arraym/ESP8266Tetris/ESP8266Tetris_Top.png

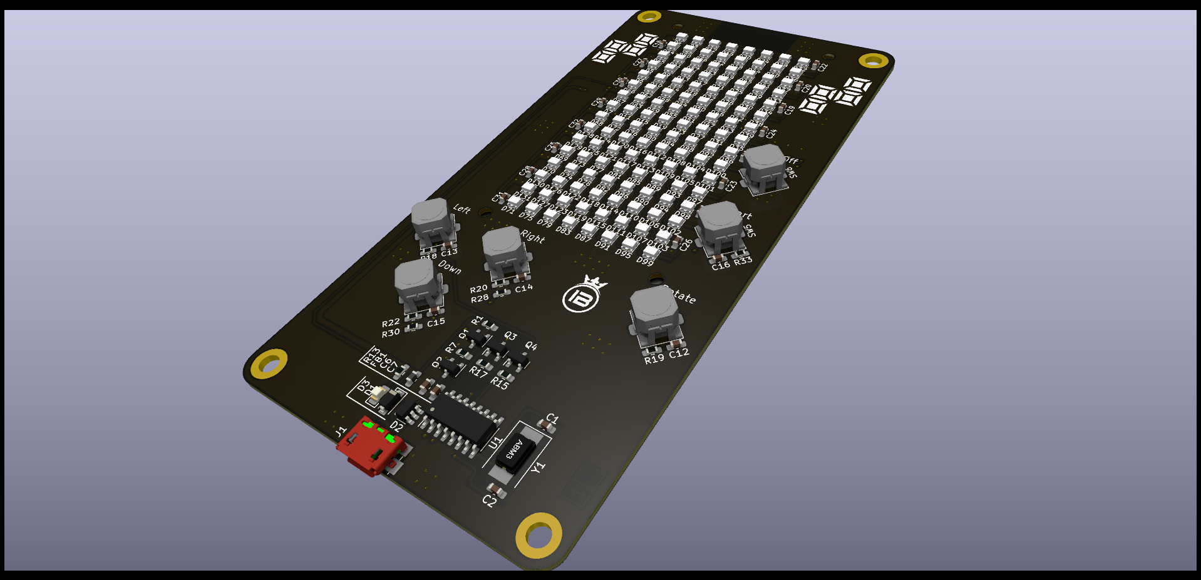
ESP8266Tetris_Top.png
