arraym/ESP8266Tetris/ESP8266Tetris_Bot.png

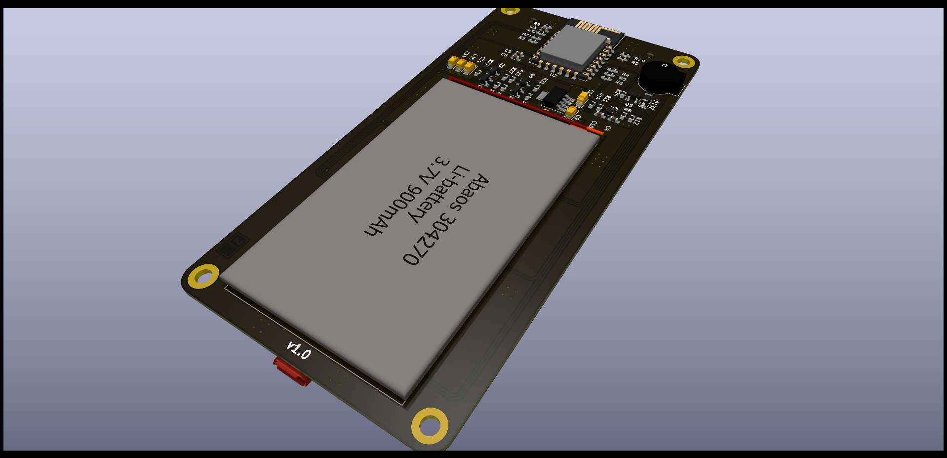
ESP8266Tetris_Bot.png
