arraym/ESP8266Tetris/Datasheets/ESP8266_PinDescription.png

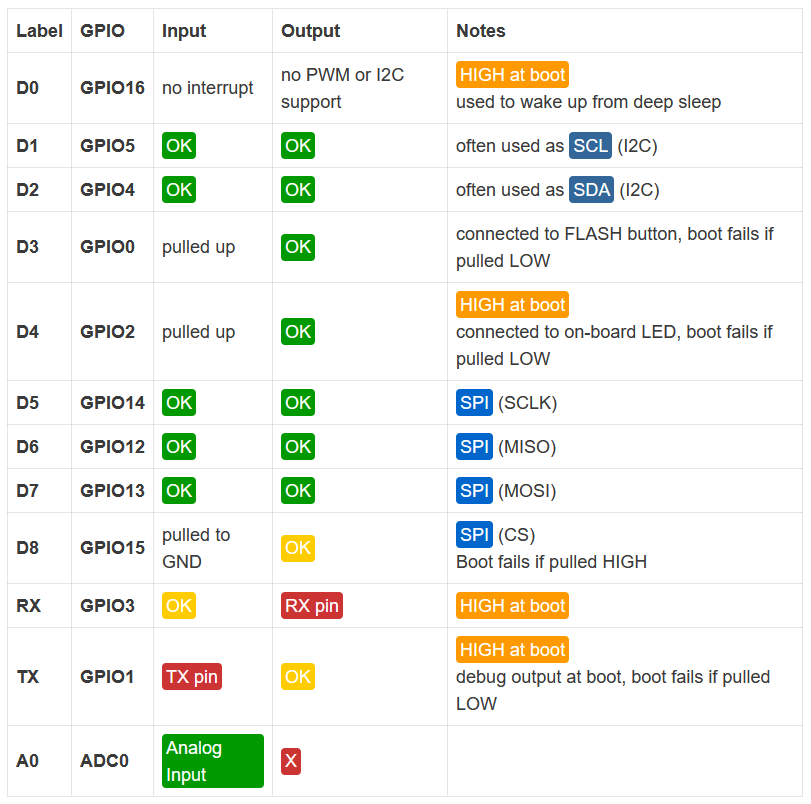
Datasheets/ESP8266_PinDescription.png
