arraym/ESP8266Tetris/Datasheets/tetris1.jpg

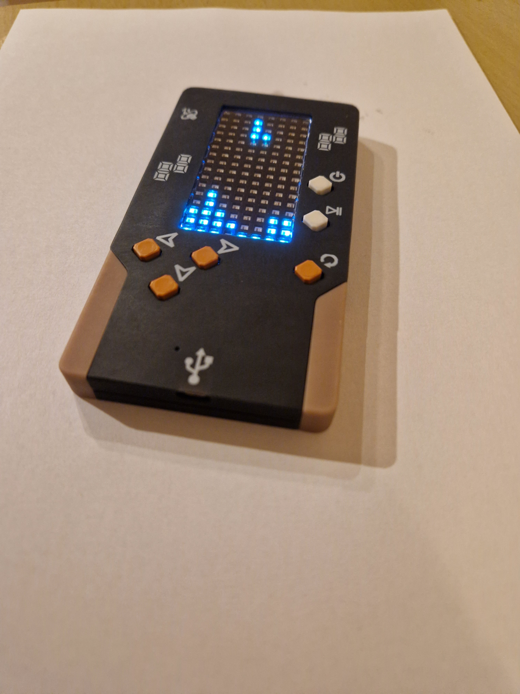
Datasheets/tetris1.jpg
