arraym/ESP8266Tetris/Datasheets/tetris2.jpg

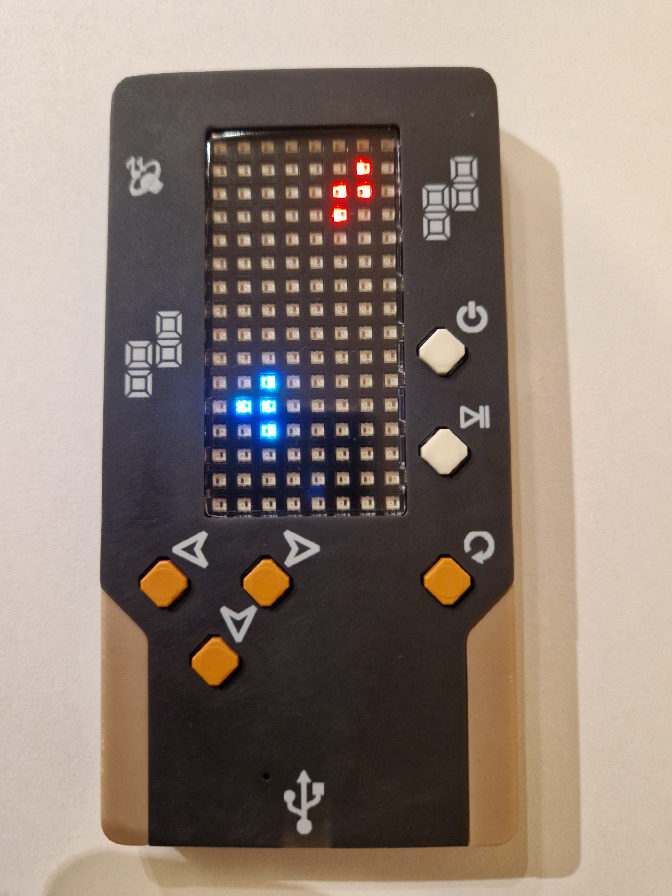
Datasheets/tetris2.jpg
