arraym/ESP8266Tetris/Datasheets/tetris3.jpg

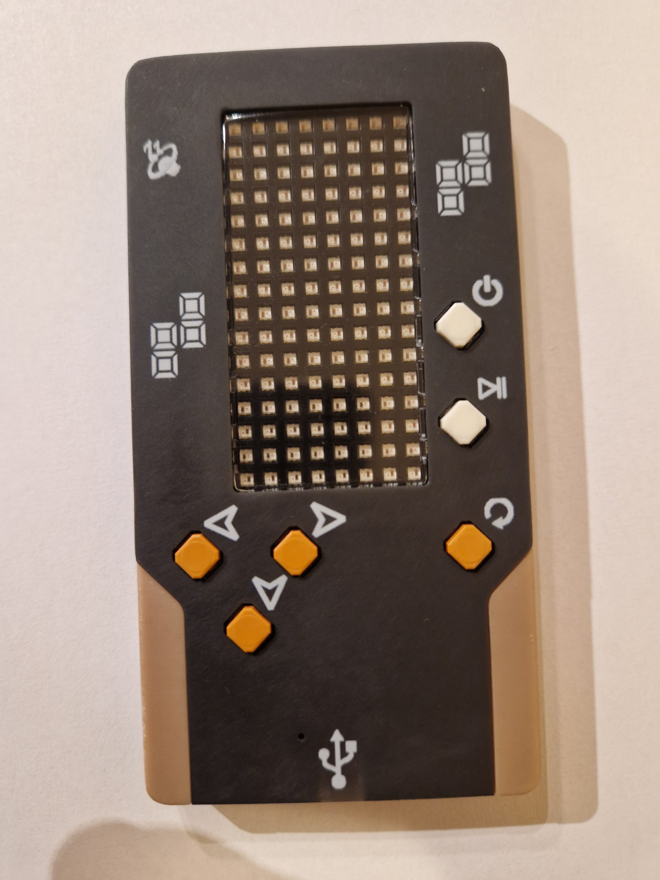
Datasheets/tetris3.jpg
