arraym/ESP8266Tetris/Datasheets/tetris4.jpg

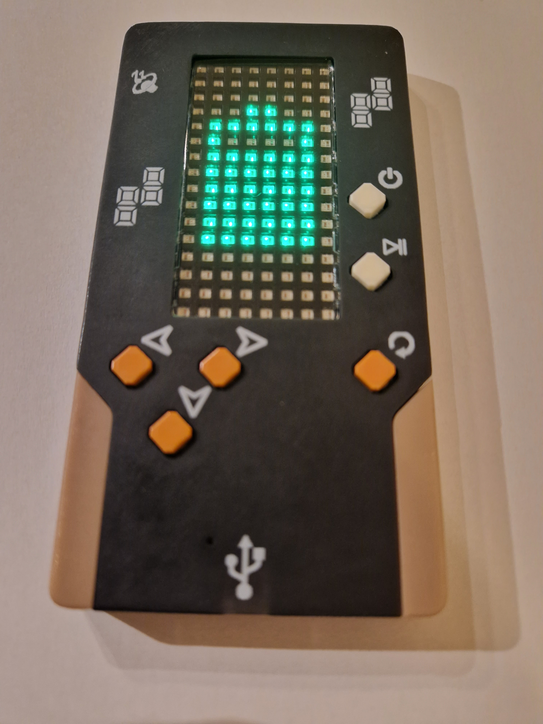
Datasheets/tetris4.jpg
