arraym/ESP8266Tetris/Datasheets/tetris5.jpg

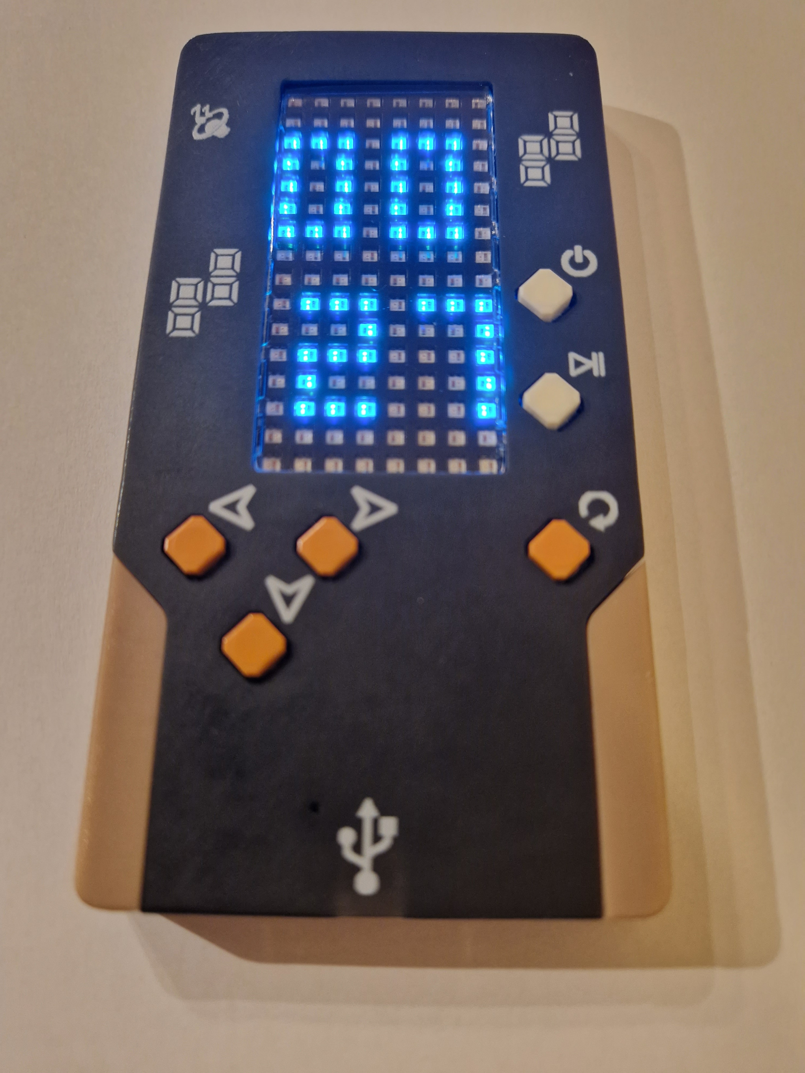
Datasheets/tetris5.jpg
