arraym/ESP8266Tetris/Datasheets/tetris6.jpg

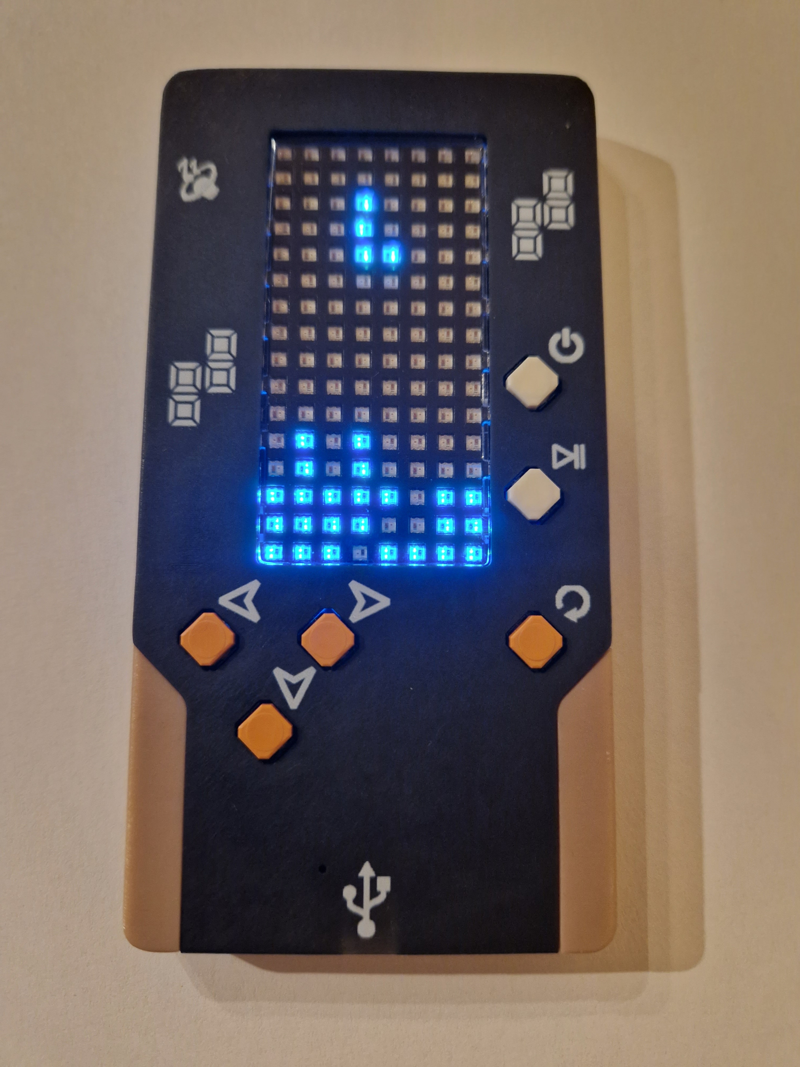
Datasheets/tetris6.jpg
