arraym/ESP8266Tetris/Datasheets/tetris7.jpg

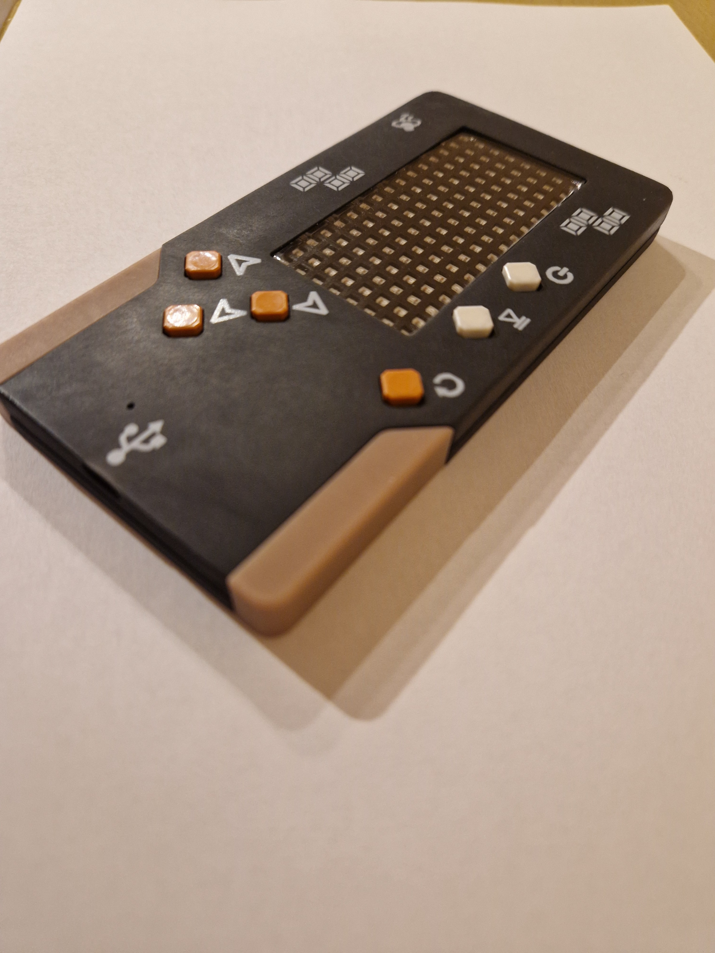
Datasheets/tetris7.jpg
