arraym/ESP8266Tetris/DocAsse/ESP8266Tetris.pdf

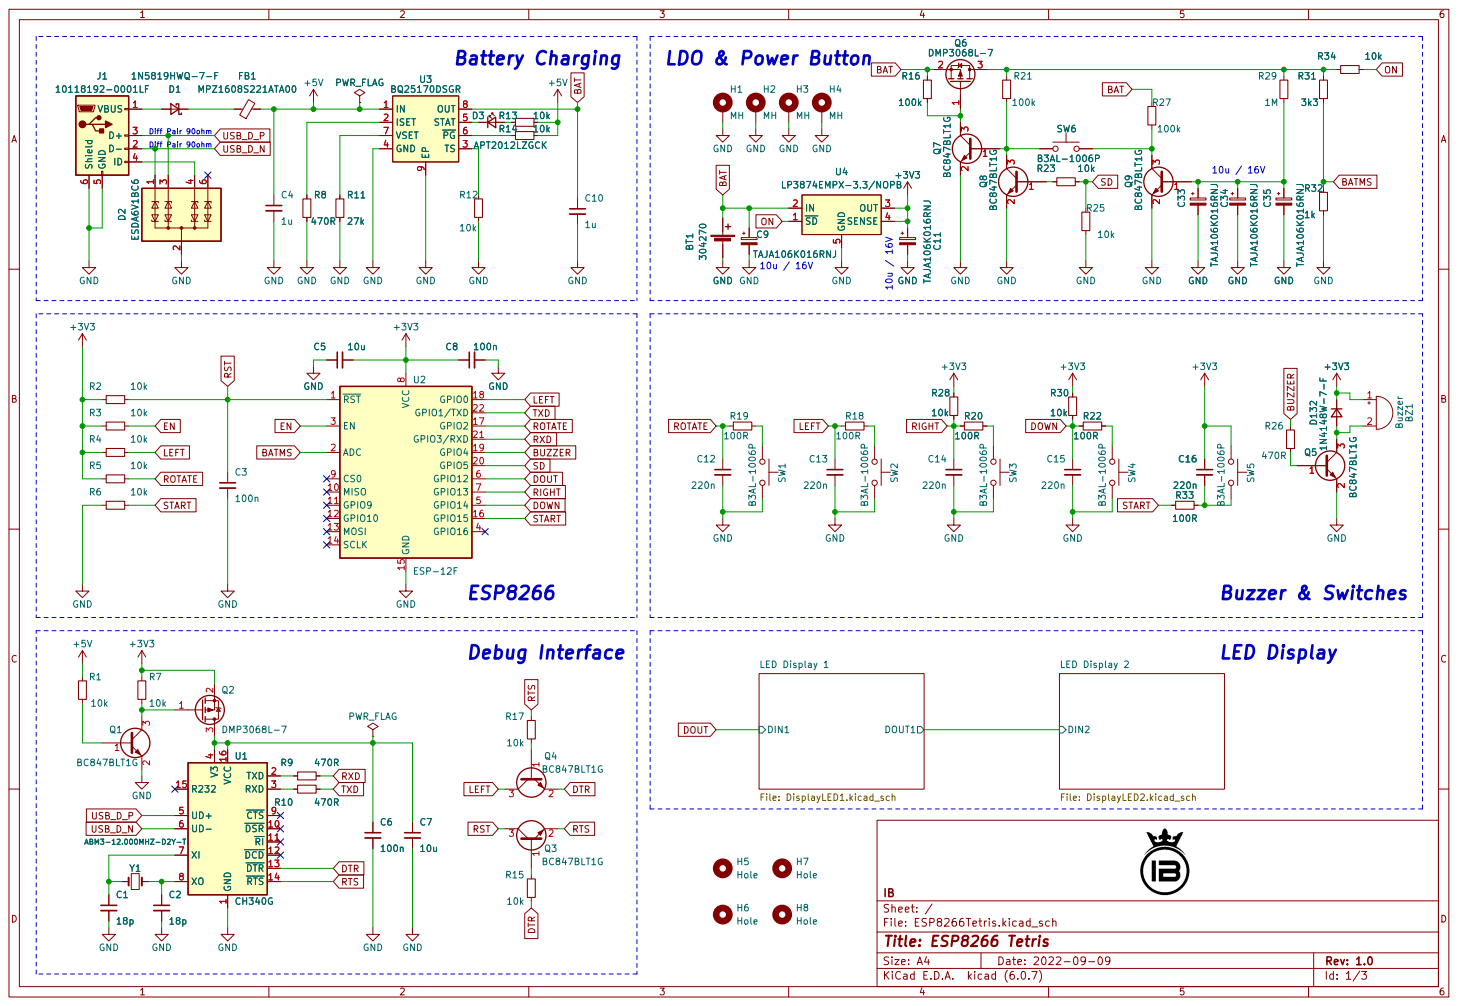
[picture p11: page 1]

4 UD+ 5 UD- 6 XI 7 XO 8 ~{CTS} 9 Y1

1 ~{DSR}10 ~{RI}11 ~{DCD}12 ~{DTR}13 ~{RTS}14 R232 15 VCC 16 TXD 2 RXD 3 V3

4 UD+ 5 UD- 6 XI 7 XO 8 ~{CTS} 9 U1CH340G
