arraym/ESP8266Tetris/ESP8266Tetris.kicad_pcb

## KiCad design ESP8266Tetris.kicad_pcb (2023-01-20)

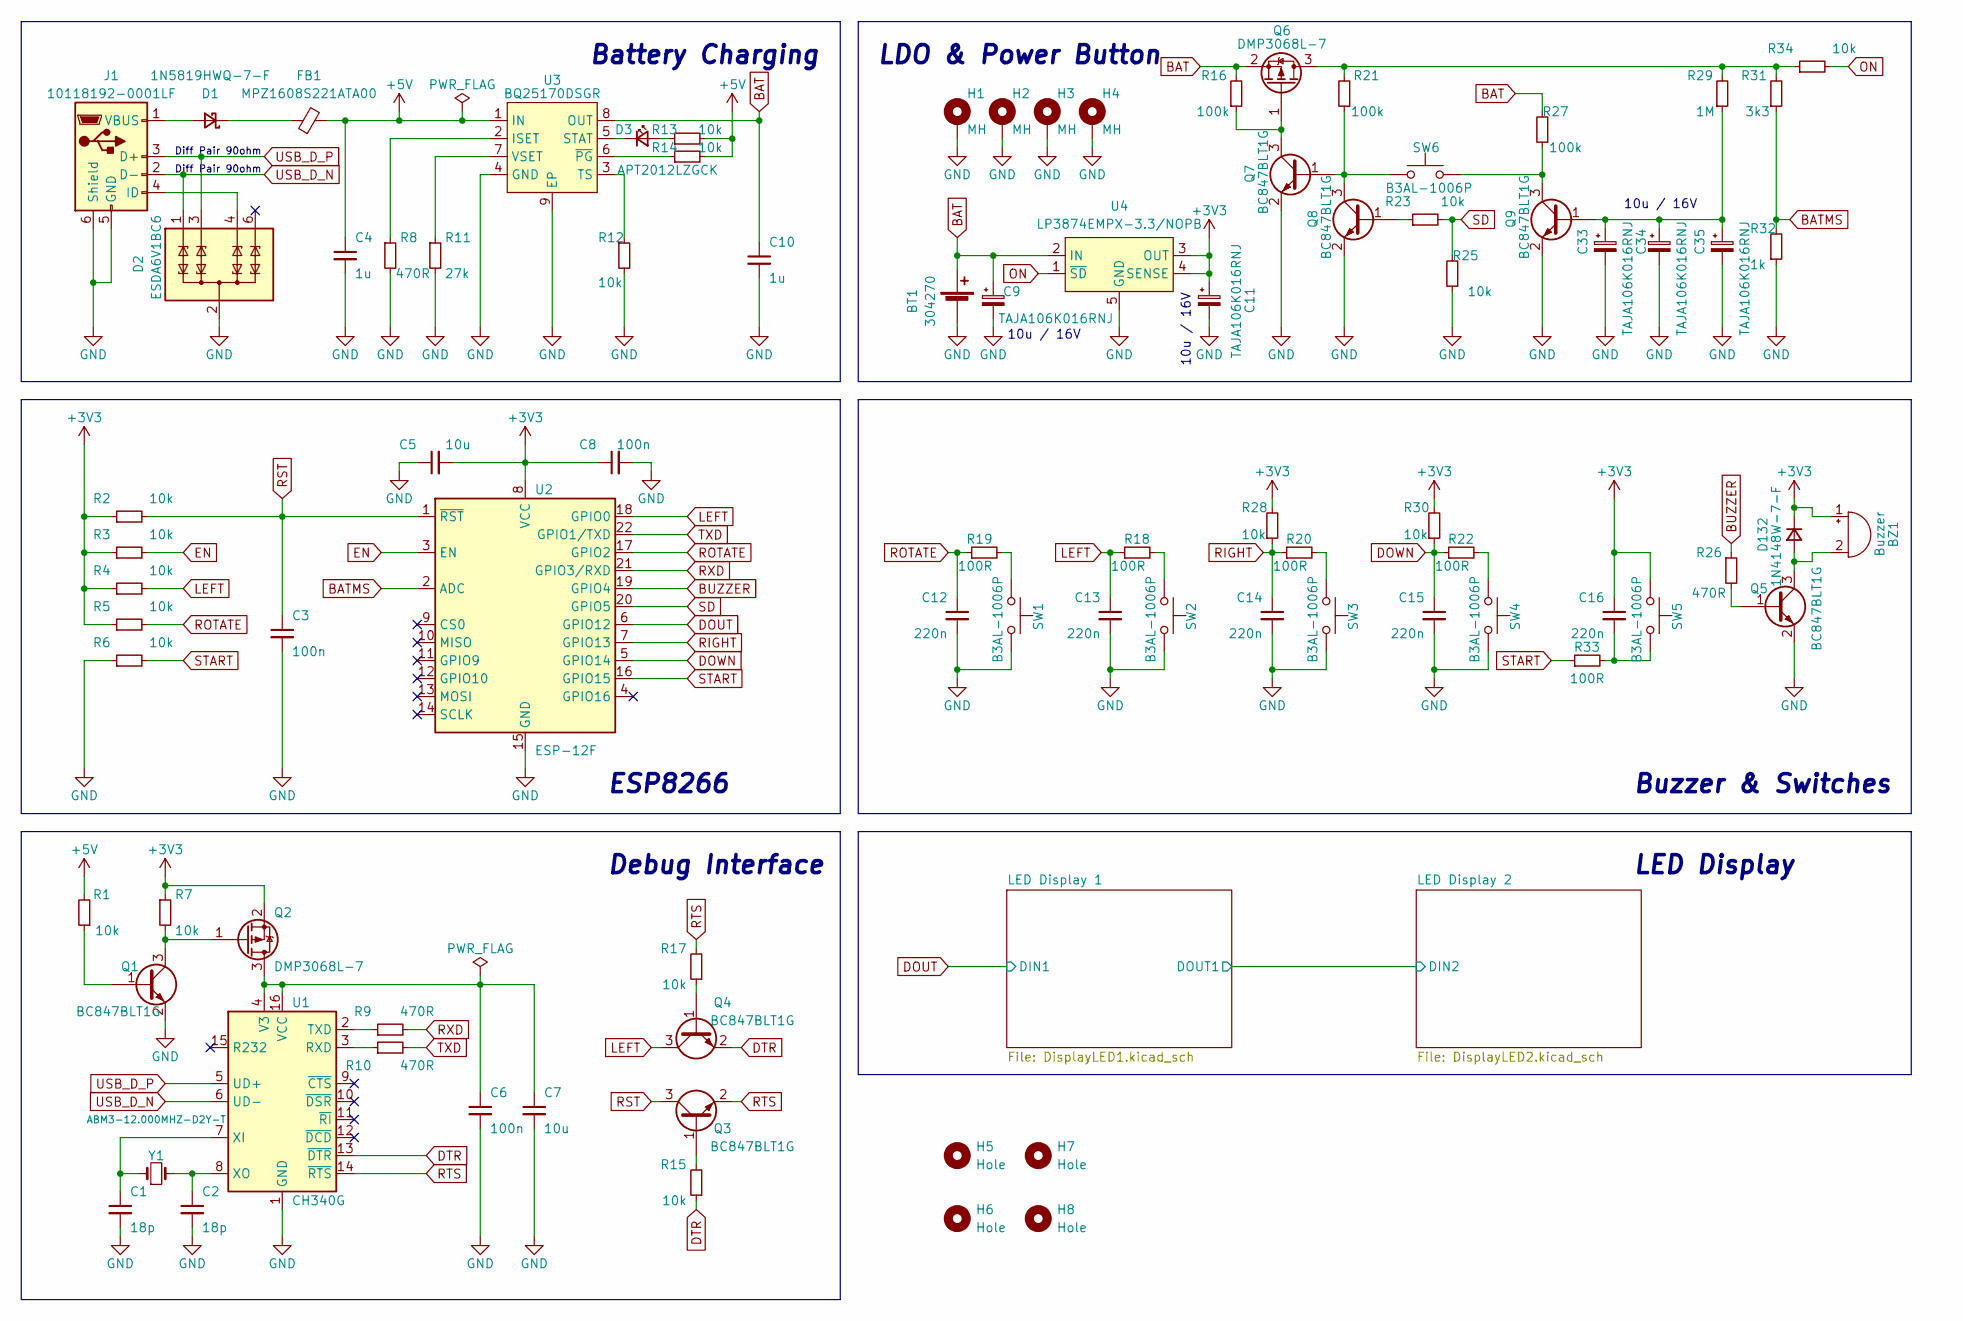
[picture p12: schematic ESP8266Tetris.kicad_sch, ESP8266 Tetris]

Parts:
BT1: 304270; Battery_LiPo_304270
BZ1: Buzzer; BUZZER_SMD
C1, C2: 18p; C_0603_1608Metric_Pad1.08x0.95mm_HandSolder
C3, C6, C8: 100n; C_0603_1608Metric_Pad1.08x0.95mm_HandSolder
C4, C10: 1u; C_0603_1608Metric_Pad1.08x0.95mm_HandSolder
C5, C7: 10u; C_0603_1608Metric_Pad1.08x0.95mm_HandSolder
C9, C11, C33, C34, C35: TAJA106K016RNJ; CP_EIA-3216-18_Kemet-A_Pad1.58x1.35mm_HandSolder
C12, C13, C14, C15, C16: 220n; C_0603_1608Metric_Pad1.08x0.95mm_HandSolder
D1: 1N5819HWQ-7-F; D_SOD-123
D2: ESDA6V1BC6; SOT-23-6
D3: APT2012LZGCK; LED_0805_2012Metric_Pad1.15x1.40mm_HandSolder
D132: 1N4148W-7-F; D_SOD-123
FB1: MPZ1608S221ATA00; L_0603_1608Metric_Pad1.05x0.95mm_HandSolder
H1, H2, H3, H4: MH; MountingHole_3.2mm_M3_DIN965_Pad
H5, H6, H7, H8: Hole; MountingHole_2.2mm_M2
J1: 10118192-0001LF; USB_Micro-B_Amphenol_10118192-0001LF_Horizontal
Q1, Q3, Q4, Q5, Q7, Q8, Q9: BC847BLT1G; SOT-23
Q2, Q6: DMP3068L-7; SOT-23
R1, R2, R3, R4, R5, R6, R7, R12, R13, R14, R15, R17, R23, R25, R28, R30, R34: 10k; R_0603_1608Metric_Pad0.98x0.95mm_HandSolder
R8, R9, R10, R26: 470R; R_0603_1608Metric_Pad0.98x0.95mm_HandSolder
R11: 27k; R_0603_1608Metric_Pad0.98x0.95mm_HandSolder
R16, R21, R27: 100k; R_0603_1608Metric_Pad0.98x0.95mm_HandSolder
R18, R19, R20, R22, R33: 100R; R_0603_1608Metric_Pad0.98x0.95mm_HandSolder
R29: 1M; R_0603_1608Metric_Pad0.98x0.95mm_HandSolder
R31: 3k3; R_0603_1608Metric_Pad0.98x0.95mm_HandSolder
R32: 1k; R_0603_1608Metric_Pad0.98x0.95mm_HandSolder
SW1, SW2, SW3, SW4, SW5, SW6: B3AL-1006P; SW_SPST_Omron_B3AL-100xP
U1: CH340G; SOIC-16_3.9x9.9mm_P1.27mm
U2: ESP-12F; ESP-12E
U3: BQ25170DSGR; WSON-8-1EP_2x2mm_P0.5mm_EP0.9x1.6mm_ThermalVias
U4: LP3874EMPX-3.3/NOPB; SOT-223-5
Y1: ABM3-12.000MHZ-D2Y-T; Crystal_SMD_7050-2Pin_7.0x5.0mm

Connections:
+3V3: BZ1.1 (-), C5.2, C8.1, C11.1, C16.1, D132.1 (K), Q2.2 (S), R2.1, R3.1, R4.1, R5.1, R7.1, R28.2, R30.2, SW5.1, U2.8 (VCC), U4.3 (OUT), U4.4 (SENSE); also elsewhere on the board
+5V: C4.1, FB1.2, R1.2, R13.2, R14.2, U3.1 (IN)
BAT: BT1.1 (+), C9.1, C10.1, Q6.2 (S), R16.2, R27.2, U3.8 (OUT), U4.2 (IN)
BATMS: R31.1, R32.2, U2.2 (ADC)
BUZZER: R26.1, U2.19 (GPIO4)
DOUT: U2.6 (GPIO12); also elsewhere on the board
DOWN: C15.1, R22.1, R30.1, U2.5 (GPIO14)
DTR: Q4.2 (E), R15.1, U1.13 (~DTR)
EN: R3.2, U2.3 (EN)
GND: BT1.2 (-), C1.2, C2.2, C3.2, C4.2, C5.1, C6.2, C7.2, C8.2, C9.2, C10.2, C11.2, C12.2, C13.2, C14.2, C15.2, C33.2, C34.2, C35.2, D2.2 (COM), D2.5 (COM), H1.1, H2.1, H3.1, H4.1, J1.5 (GND), J1.6 (Shield), Q1.2 (E), Q5.2 (E), Q7.2 (E), Q8.2 (E), Q9.2 (E), R6.1, R8.2, R11.2, R12.2, R25.1, R32.1, SW1.2, SW2.2, SW3.2, SW4.2, U1.1 (GND), U2.15 (GND), U3.4 (GND), U3.9 (EP), U4.5 (GND); also elsewhere on the board
LEFT: C13.1, Q4.3 (C), R4.2, R18.1, U2.18 (GPIO0)
unnamed: BZ1.2 (+), D132.2 (A), Q5.3 (C)
unnamed: C1.1, U1.7 (XI), Y1.1
unnamed: C2.1, U1.8 (XO), Y1.2
unnamed: C6.1, C7.1, Q2.3 (D), U1.4 (V3), U1.16 (VCC)
unnamed: C16.2, R33.2, SW5.2
unnamed: C33.1, C34.1, C35.1, Q9.1 (B), R29.1
unnamed: D1.1 (K), FB1.1
unnamed: D1.2 (A), J1.1 (VBUS)
unnamed: D2.4 (TVS3), J1.4 (ID)
unnamed: D3.1 (K), U3.5 (STAT)
unnamed: D3.2 (A), R13.1
unnamed: Q1.1 (B), R1.1
unnamed: Q1.3 (C), Q2.1 (G), R7.2
unnamed: Q3.1 (B), R15.2
unnamed: Q4.1 (B), R17.1
unnamed: Q5.1 (B), R26.2
unnamed: Q6.1 (G), Q7.3 (C), R16.1
unnamed: Q6.3 (D), R21.2, R29.2, R31.2, R34.1
unnamed: Q7.1 (B), Q8.3 (C), R21.1, SW6.1
unnamed: Q8.1 (B), R23.1
unnamed: Q9.3 (C), R27.1, SW6.2
unnamed: R8.1, U3.2 (ISET)
unnamed: R9.1, U1.2 (TXD)
unnamed: R10.1, U1.3 (RXD)
unnamed: R11.1, U3.7 (VSET)
unnamed: R12.1, U3.3 (TS)
unnamed: R14.1, U3.6 (~PG)
unnamed: R18.2, SW2.1
unnamed: R19.2, SW1.1
unnamed: R20.2, SW3.1
unnamed: R22.2, SW4.1
ON: R34.2, U4.1 (~SD)
RIGHT: C14.1, R20.1, R28.1, U2.7 (GPIO13)
ROTATE: C12.1, R5.2, R19.1, U2.17 (GPIO2)
RST: C3.1, Q3.3 (C), R2.2, U2.1 (~RST)
RTS: Q3.2 (E), R17.2, U1.14 (~RTS)
RXD: R9.2, U2.21 (GPIO3/RXD)
SD: R23.2, R25.2, U2.20 (GPIO5)
START: R6.2, R33.1, U2.16 (GPIO15)
TXD: R10.2, U2.22 (GPIO1/TXD)
USB_D_N: D2.1 (TVS1), J1.2 (D-), U1.6 (UD-)
USB_D_P: D2.3 (TVS2), J1.3 (D+), U1.5 (UD+)

Notes on the sheet:
ESP8266
Diff Pair 90ohm
10u / 16V
LDO & Power Button
Buzzer & Switches
Debug Interface
LED Display
Battery Charging

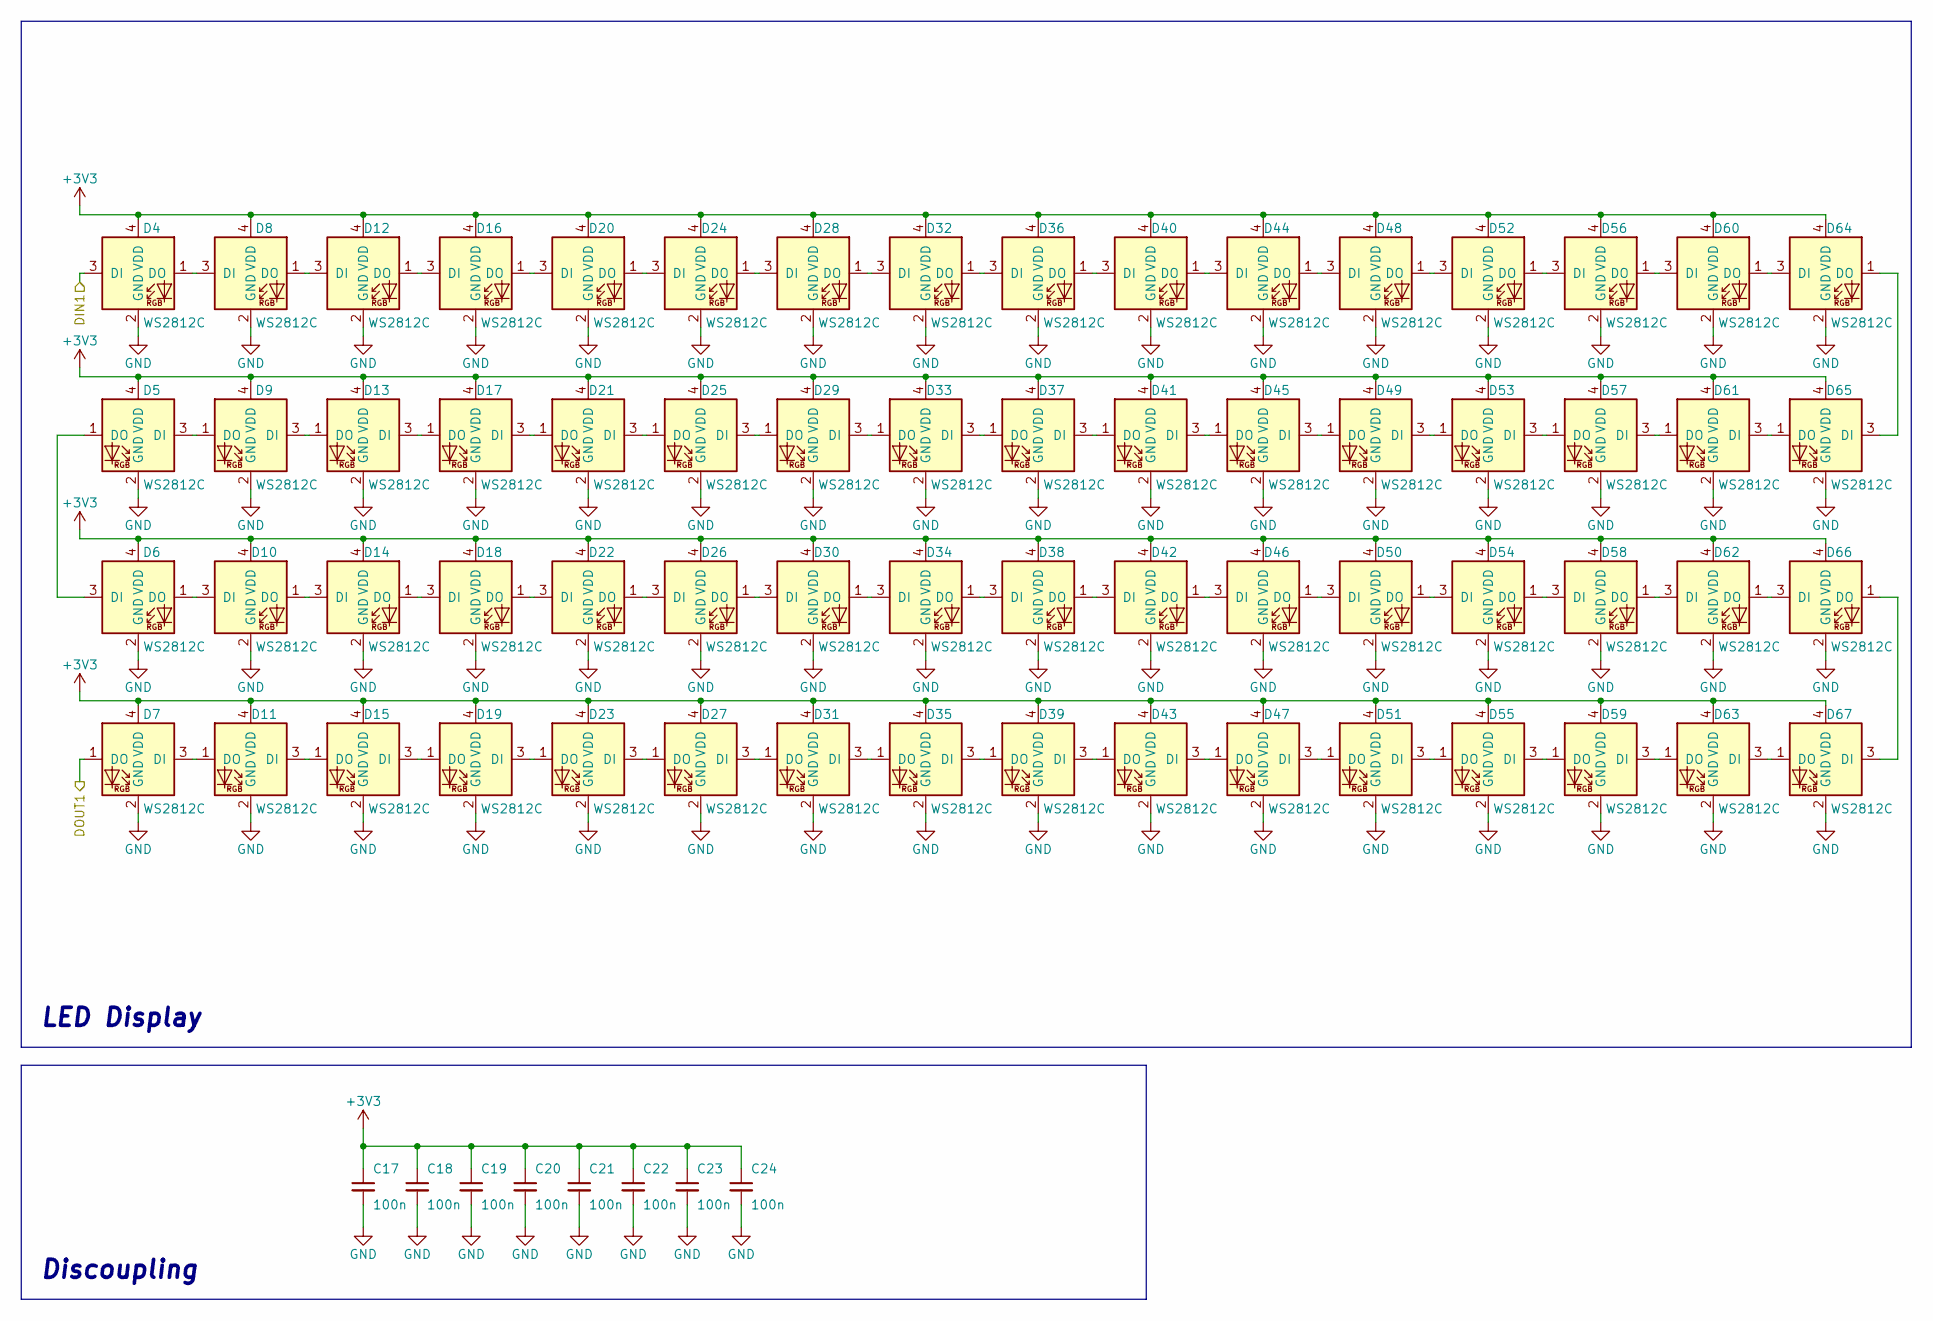
[picture p13: schematic DisplayLED1.kicad_sch, ESP8266 Tetris]

Parts:
C17, C18, C19, C20, C21, C22, C23, C24: 100n; C_0603_1608Metric_Pad1.08x0.95mm_HandSolder
D4, D5, D6, D7, D8, D9, D10, D11, D12, D13, D14, D15, D16, D17, D18, D19, D20, D21, D22, D23, D24, D25, D26, D27, D28, D29, D30, D31, D32, D33, D34, D35, D36, D37, D38, D39, D40, D41, D42, D43, D44, D45, D46, D47, D48, D49, D50, D51, D52, D53, D54, D55, D56, D57, D58, D59, D60, D61, D62, D63, D64, D65, D66, D67: WS2812C; WS2812-2020

Connections:
+3V3: C17.1, C18.1, C19.1, C20.1, C21.1, C22.1, C23.1, C24.1, D4.4 (VDD), D5.4 (VDD), D6.4 (VDD), D7.4 (VDD), D8.4 (VDD), D9.4 (VDD), D10.4 (VDD), D11.4 (VDD), D12.4 (VDD), D13.4 (VDD), D14.4 (VDD), D15.4 (VDD), D16.4 (VDD), D17.4 (VDD), D18.4 (VDD), D19.4 (VDD), D20.4 (VDD), D21.4 (VDD), D22.4 (VDD), D23.4 (VDD), D24.4 (VDD), D25.4 (VDD), D26.4 (VDD), D27.4 (VDD), D28.4 (VDD), D29.4 (VDD), D30.4 (VDD), D31.4 (VDD), D32.4 (VDD), D33.4 (VDD), D34.4 (VDD), D35.4 (VDD), D36.4 (VDD), D37.4 (VDD), D38.4 (VDD), D39.4 (VDD), D40.4 (VDD), D41.4 (VDD), D42.4 (VDD), D43.4 (VDD), D44.4 (VDD), D45.4 (VDD), D46.4 (VDD), D47.4 (VDD), D48.4 (VDD), D49.4 (VDD), D50.4 (VDD), D51.4 (VDD), D52.4 (VDD), D53.4 (VDD), D54.4 (VDD), D55.4 (VDD), D56.4 (VDD), D57.4 (VDD), D58.4 (VDD), D59.4 (VDD), D60.4 (VDD), D61.4 (VDD), D62.4 (VDD), D63.4 (VDD), D64.4 (VDD), D65.4 (VDD), D66.4 (VDD), D67.4 (VDD); also elsewhere on the board
/LED Display 1/DOUT1: D7.1 (DO); also elsewhere on the board
DOUT: D4.3 (DI); also elsewhere on the board
GND: C17.2, C18.2, C19.2, C20.2, C21.2, C22.2, C23.2, C24.2, D4.2 (GND), D5.2 (GND), D6.2 (GND), D7.2 (GND), D8.2 (GND), D9.2 (GND), D10.2 (GND), D11.2 (GND), D12.2 (GND), D13.2 (GND), D14.2 (GND), D15.2 (GND), D16.2 (GND), D17.2 (GND), D18.2 (GND), D19.2 (GND), D20.2 (GND), D21.2 (GND), D22.2 (GND), D23.2 (GND), D24.2 (GND), D25.2 (GND), D26.2 (GND), D27.2 (GND), D28.2 (GND), D29.2 (GND), D30.2 (GND), D31.2 (GND), D32.2 (GND), D33.2 (GND), D34.2 (GND), D35.2 (GND), D36.2 (GND), D37.2 (GND), D38.2 (GND), D39.2 (GND), D40.2 (GND), D41.2 (GND), D42.2 (GND), D43.2 (GND), D44.2 (GND), D45.2 (GND), D46.2 (GND), D47.2 (GND), D48.2 (GND), D49.2 (GND), D50.2 (GND), D51.2 (GND), D52.2 (GND), D53.2 (GND), D54.2 (GND), D55.2 (GND), D56.2 (GND), D57.2 (GND), D58.2 (GND), D59.2 (GND), D60.2 (GND), D61.2 (GND), D62.2 (GND), D63.2 (GND), D64.2 (GND), D65.2 (GND), D66.2 (GND), D67.2 (GND); also elsewhere on the board
unnamed: D4.1 (DO), D8.3 (DI)
unnamed: D5.1 (DO), D6.3 (DI)
unnamed: D5.3 (DI), D9.1 (DO)
unnamed: D10.1 (DO), D14.3 (DI)
unnamed: D6.1 (DO), D10.3 (DI)
unnamed: D7.3 (DI), D11.1 (DO)
unnamed: D11.3 (DI), D15.1 (DO)
unnamed: D12.1 (DO), D16.3 (DI)
unnamed: D8.1 (DO), D12.3 (DI)
unnamed: D9.3 (DI), D13.1 (DO)
unnamed: D13.3 (DI), D17.1 (DO)
unnamed: D14.1 (DO), D18.3 (DI)
unnamed: D15.3 (DI), D19.1 (DO)
unnamed: D16.1 (DO), D20.3 (DI)
unnamed: D17.3 (DI), D21.1 (DO)
unnamed: D18.1 (DO), D22.3 (DI)
unnamed: D19.3 (DI), D23.1 (DO)
unnamed: D20.1 (DO), D24.3 (DI)
unnamed: D21.3 (DI), D25.1 (DO)
unnamed: D22.1 (DO), D26.3 (DI)
unnamed: D23.3 (DI), D27.1 (DO)
unnamed: D24.1 (DO), D28.3 (DI)
unnamed: D25.3 (DI), D29.1 (DO)
unnamed: D26.1 (DO), D30.3 (DI)
unnamed: D27.3 (DI), D31.1 (DO)
unnamed: D28.1 (DO), D32.3 (DI)
unnamed: D29.3 (DI), D33.1 (DO)
unnamed: D30.1 (DO), D34.3 (DI)
unnamed: D31.3 (DI), D35.1 (DO)
unnamed: D32.1 (DO), D36.3 (DI)
unnamed: D33.3 (DI), D37.1 (DO)
unnamed: D34.1 (DO), D38.3 (DI)
unnamed: D35.3 (DI), D39.1 (DO)
unnamed: D36.1 (DO), D40.3 (DI)
unnamed: D37.3 (DI), D41.1 (DO)
unnamed: D38.1 (DO), D42.3 (DI)
unnamed: D39.3 (DI), D43.1 (DO)
unnamed: D40.1 (DO), D44.3 (DI)
unnamed: D41.3 (DI), D45.1 (DO)
unnamed: D42.1 (DO), D46.3 (DI)
unnamed: D43.3 (DI), D47.1 (DO)
unnamed: D44.1 (DO), D48.3 (DI)
unnamed: D45.3 (DI), D49.1 (DO)
unnamed: D46.1 (DO), D50.3 (DI)
unnamed: D47.3 (DI), D51.1 (DO)
unnamed: D48.1 (DO), D52.3 (DI)
unnamed: D49.3 (DI), D53.1 (DO)
unnamed: D50.1 (DO), D54.3 (DI)
unnamed: D51.3 (DI), D55.1 (DO)
unnamed: D52.1 (DO), D56.3 (DI)
unnamed: D53.3 (DI), D57.1 (DO)
unnamed: D54.1 (DO), D58.3 (DI)
unnamed: D55.3 (DI), D59.1 (DO)
unnamed: D56.1 (DO), D60.3 (DI)
unnamed: D57.3 (DI), D61.1 (DO)
unnamed: D58.1 (DO), D62.3 (DI)
unnamed: D59.3 (DI), D63.1 (DO)
unnamed: D60.1 (DO), D64.3 (DI)
unnamed: D61.3 (DI), D65.1 (DO)
unnamed: D62.1 (DO), D66.3 (DI)
unnamed: D63.3 (DI), D67.1 (DO)
unnamed: D64.1 (DO), D65.3 (DI)
unnamed: D66.1 (DO), D67.3 (DI)

Notes on the sheet:
Discoupling
LED Display

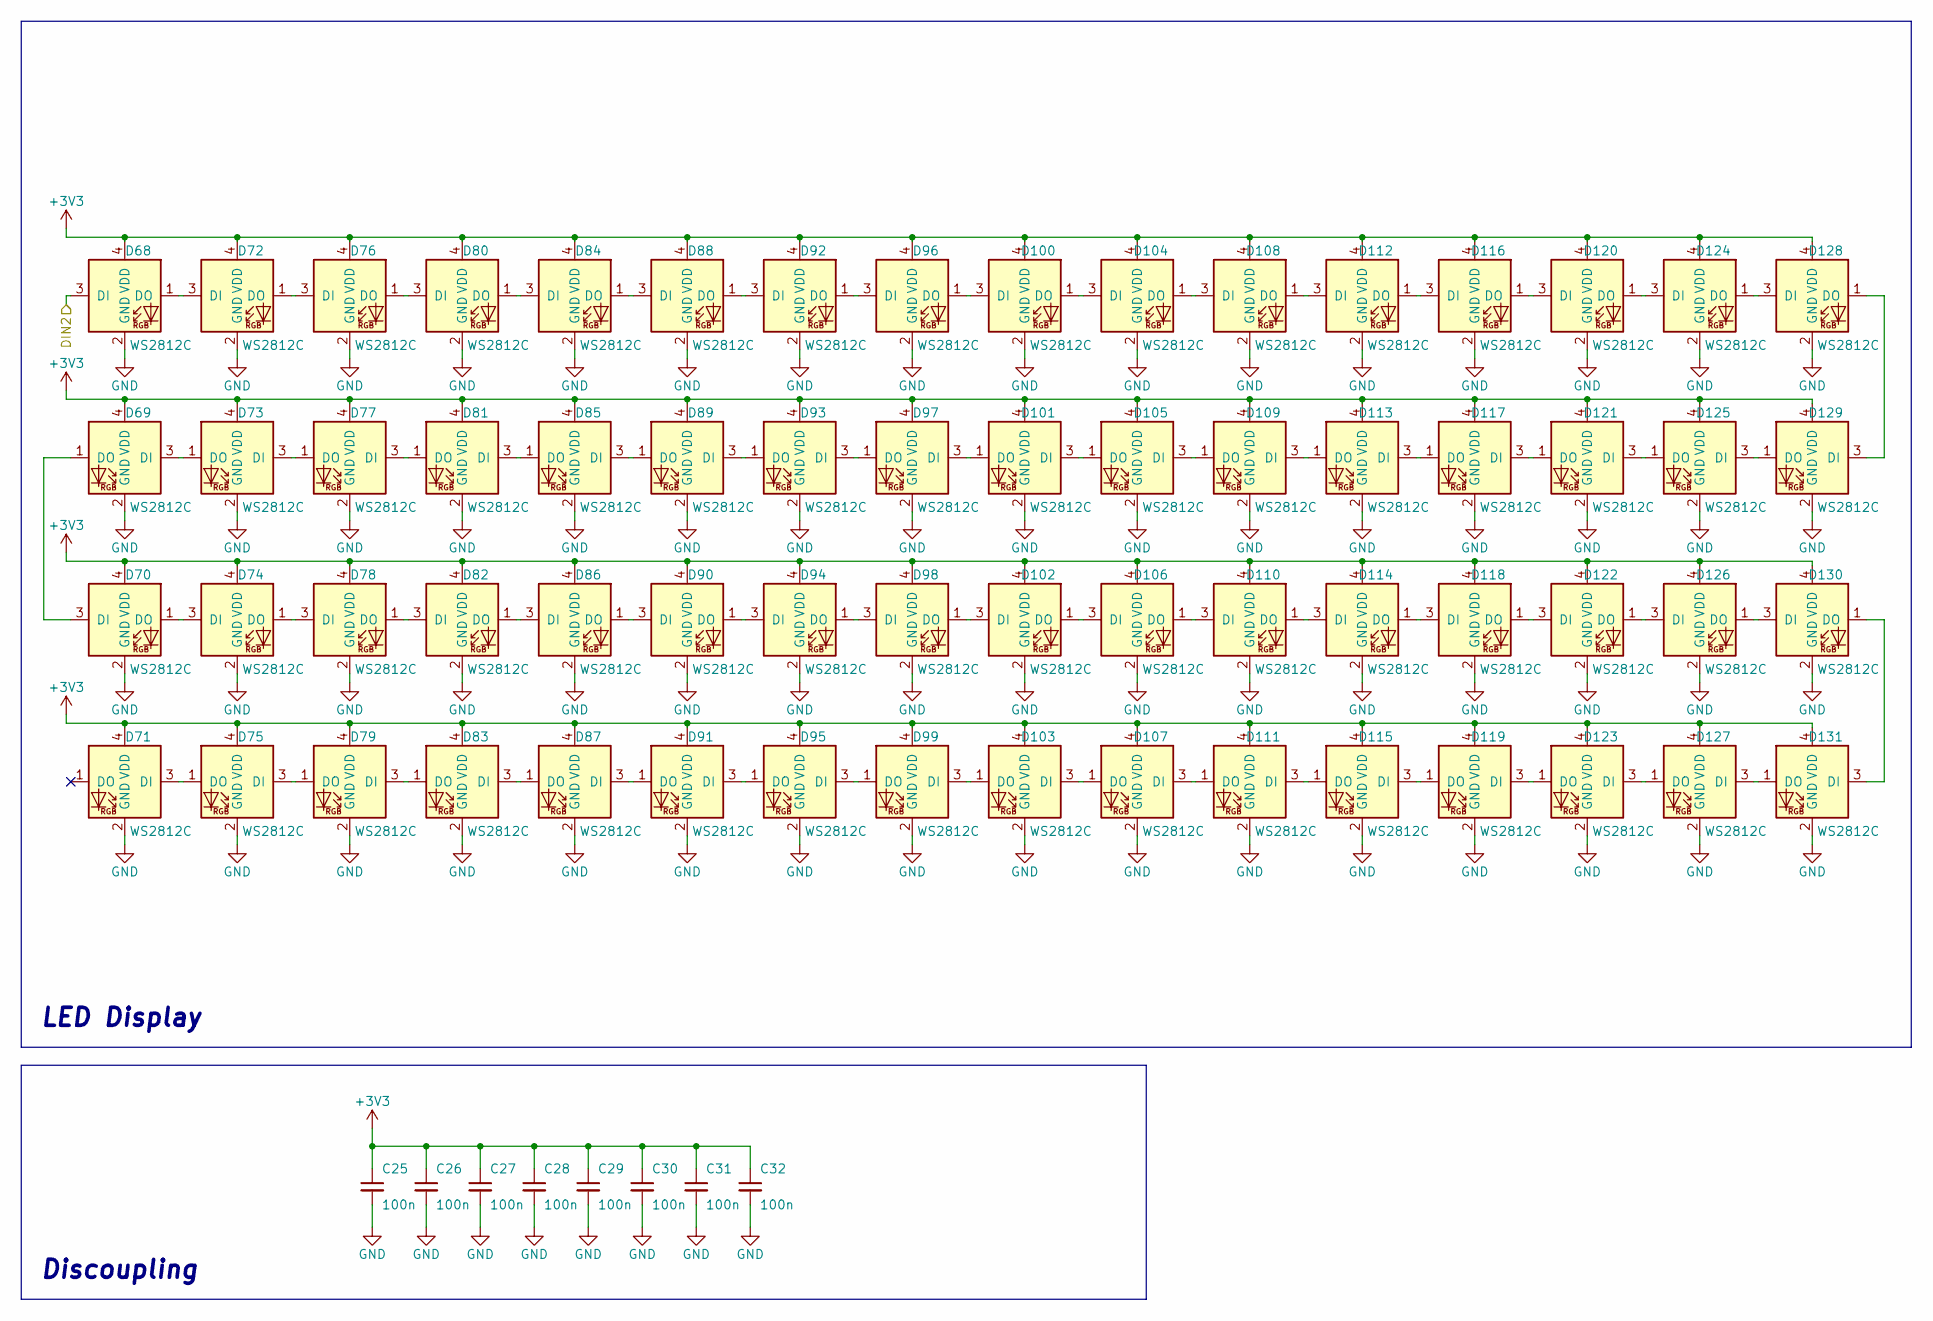
[picture p14: schematic DisplayLED2.kicad_sch, ESP8266 Tetris]

Parts:
C25, C26, C27, C28, C29, C30, C31, C32: 100n; C_0603_1608Metric_Pad1.08x0.95mm_HandSolder
D68, D69, D70, D71, D72, D73, D74, D75, D76, D77, D78, D79, D80, D81, D82, D83, D84, D85, D86, D87, D88, D89, D90, D91, D92, D93, D94, D95, D96, D97, D98, D99, D100, D101, D102, D103, D104, D105, D106, D107, D108, D109, D110, D111, D112, D113, D114, D115, D116, D117, D118, D119, D120, D121, D122, D123, D124, D125, D126, D127, D128, D129, D130, D131: WS2812C; WS2812-2020

Connections:
+3V3: C25.1, C26.1, C27.1, C28.1, C29.1, C30.1, C31.1, C32.1, D68.4 (VDD), D69.4 (VDD), D70.4 (VDD), D71.4 (VDD), D72.4 (VDD), D73.4 (VDD), D74.4 (VDD), D75.4 (VDD), D76.4 (VDD), D77.4 (VDD), D78.4 (VDD), D79.4 (VDD), D80.4 (VDD), D81.4 (VDD), D82.4 (VDD), D83.4 (VDD), D84.4 (VDD), D85.4 (VDD), D86.4 (VDD), D87.4 (VDD), D88.4 (VDD), D89.4 (VDD), D90.4 (VDD), D91.4 (VDD), D92.4 (VDD), D93.4 (VDD), D94.4 (VDD), D95.4 (VDD), D96.4 (VDD), D97.4 (VDD), D98.4 (VDD), D99.4 (VDD), D100.4 (VDD), D101.4 (VDD), D102.4 (VDD), D103.4 (VDD), D104.4 (VDD), D105.4 (VDD), D106.4 (VDD), D107.4 (VDD), D108.4 (VDD), D109.4 (VDD), D110.4 (VDD), D111.4 (VDD), D112.4 (VDD), D113.4 (VDD), D114.4 (VDD), D115.4 (VDD), D116.4 (VDD), D117.4 (VDD), D118.4 (VDD), D119.4 (VDD), D120.4 (VDD), D121.4 (VDD), D122.4 (VDD), D123.4 (VDD), D124.4 (VDD), D125.4 (VDD), D126.4 (VDD), D127.4 (VDD), D128.4 (VDD), D129.4 (VDD), D130.4 (VDD), D131.4 (VDD); also elsewhere on the board
/LED Display 1/DOUT1: D68.3 (DI); also elsewhere on the board
GND: C25.2, C26.2, C27.2, C28.2, C29.2, C30.2, C31.2, C32.2, D68.2 (GND), D69.2 (GND), D70.2 (GND), D71.2 (GND), D72.2 (GND), D73.2 (GND), D74.2 (GND), D75.2 (GND), D76.2 (GND), D77.2 (GND), D78.2 (GND), D79.2 (GND), D80.2 (GND), D81.2 (GND), D82.2 (GND), D83.2 (GND), D84.2 (GND), D85.2 (GND), D86.2 (GND), D87.2 (GND), D88.2 (GND), D89.2 (GND), D90.2 (GND), D91.2 (GND), D92.2 (GND), D93.2 (GND), D94.2 (GND), D95.2 (GND), D96.2 (GND), D97.2 (GND), D98.2 (GND), D99.2 (GND), D100.2 (GND), D101.2 (GND), D102.2 (GND), D103.2 (GND), D104.2 (GND), D105.2 (GND), D106.2 (GND), D107.2 (GND), D108.2 (GND), D109.2 (GND), D110.2 (GND), D111.2 (GND), D112.2 (GND), D113.2 (GND), D114.2 (GND), D115.2 (GND), D116.2 (GND), D117.2 (GND), D118.2 (GND), D119.2 (GND), D120.2 (GND), D121.2 (GND), D122.2 (GND), D123.2 (GND), D124.2 (GND), D125.2 (GND), D126.2 (GND), D127.2 (GND), D128.2 (GND), D129.2 (GND), D130.2 (GND), D131.2 (GND); also elsewhere on the board
unnamed: D68.1 (DO), D72.3 (DI)
unnamed: D69.1 (DO), D70.3 (DI)
unnamed: D69.3 (DI), D73.1 (DO)
unnamed: D70.1 (DO), D74.3 (DI)
unnamed: D71.3 (DI), D75.1 (DO)
unnamed: D72.1 (DO), D76.3 (DI)
unnamed: D73.3 (DI), D77.1 (DO)
unnamed: D74.1 (DO), D78.3 (DI)
unnamed: D75.3 (DI), D79.1 (DO)
unnamed: D76.1 (DO), D80.3 (DI)
unnamed: D77.3 (DI), D81.1 (DO)
unnamed: D78.1 (DO), D82.3 (DI)
unnamed: D79.3 (DI), D83.1 (DO)
unnamed: D80.1 (DO), D84.3 (DI)
unnamed: D81.3 (DI), D85.1 (DO)
unnamed: D82.1 (DO), D86.3 (DI)
unnamed: D83.3 (DI), D87.1 (DO)
unnamed: D84.1 (DO), D88.3 (DI)
unnamed: D85.3 (DI), D89.1 (DO)
unnamed: D86.1 (DO), D90.3 (DI)
unnamed: D87.3 (DI), D91.1 (DO)
unnamed: D88.1 (DO), D92.3 (DI)
unnamed: D89.3 (DI), D93.1 (DO)
unnamed: D90.1 (DO), D94.3 (DI)
unnamed: D91.3 (DI), D95.1 (DO)
unnamed: D92.1 (DO), D96.3 (DI)
unnamed: D93.3 (DI), D97.1 (DO)
unnamed: D94.1 (DO), D98.3 (DI)
unnamed: D95.3 (DI), D99.1 (DO)
unnamed: D100.1 (DO), D104.3 (DI)
unnamed: D96.1 (DO), D100.3 (DI)
unnamed: D97.3 (DI), D101.1 (DO)
unnamed: D101.3 (DI), D105.1 (DO)
unnamed: D102.1 (DO), D106.3 (DI)
unnamed: D98.1 (DO), D102.3 (DI)
unnamed: D99.3 (DI), D103.1 (DO)
unnamed: D103.3 (DI), D107.1 (DO)
unnamed: D104.1 (DO), D108.3 (DI)
unnamed: D105.3 (DI), D109.1 (DO)
unnamed: D106.1 (DO), D110.3 (DI)
unnamed: D107.3 (DI), D111.1 (DO)
unnamed: D108.1 (DO), D112.3 (DI)
unnamed: D109.3 (DI), D113.1 (DO)
unnamed: D110.1 (DO), D114.3 (DI)
unnamed: D111.3 (DI), D115.1 (DO)
unnamed: D112.1 (DO), D116.3 (DI)
unnamed: D113.3 (DI), D117.1 (DO)
unnamed: D114.1 (DO), D118.3 (DI)
unnamed: D115.3 (DI), D119.1 (DO)
unnamed: D116.1 (DO), D120.3 (DI)
unnamed: D117.3 (DI), D121.1 (DO)
unnamed: D118.1 (DO), D122.3 (DI)
unnamed: D119.3 (DI), D123.1 (DO)
unnamed: D120.1 (DO), D124.3 (DI)
unnamed: D121.3 (DI), D125.1 (DO)
unnamed: D122.1 (DO), D126.3 (DI)
unnamed: D123.3 (DI), D127.1 (DO)
unnamed: D124.1 (DO), D128.3 (DI)
unnamed: D125.3 (DI), D129.1 (DO)
unnamed: D126.1 (DO), D130.3 (DI)
unnamed: D127.3 (DI), D131.1 (DO)
unnamed: D128.1 (DO), D129.3 (DI)
unnamed: D130.1 (DO), D131.3 (DI)

Notes on the sheet:
LED Display
Discoupling

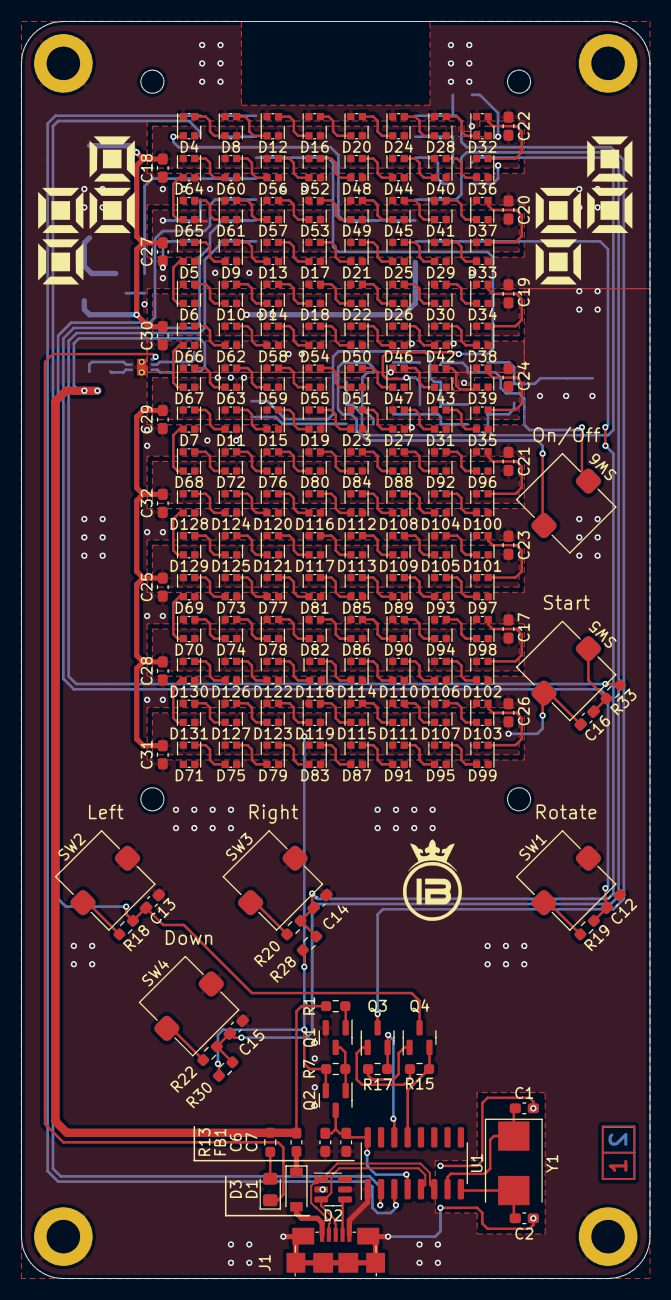
[picture p15: board ESP8266Tetris.kicad_pcb from above]

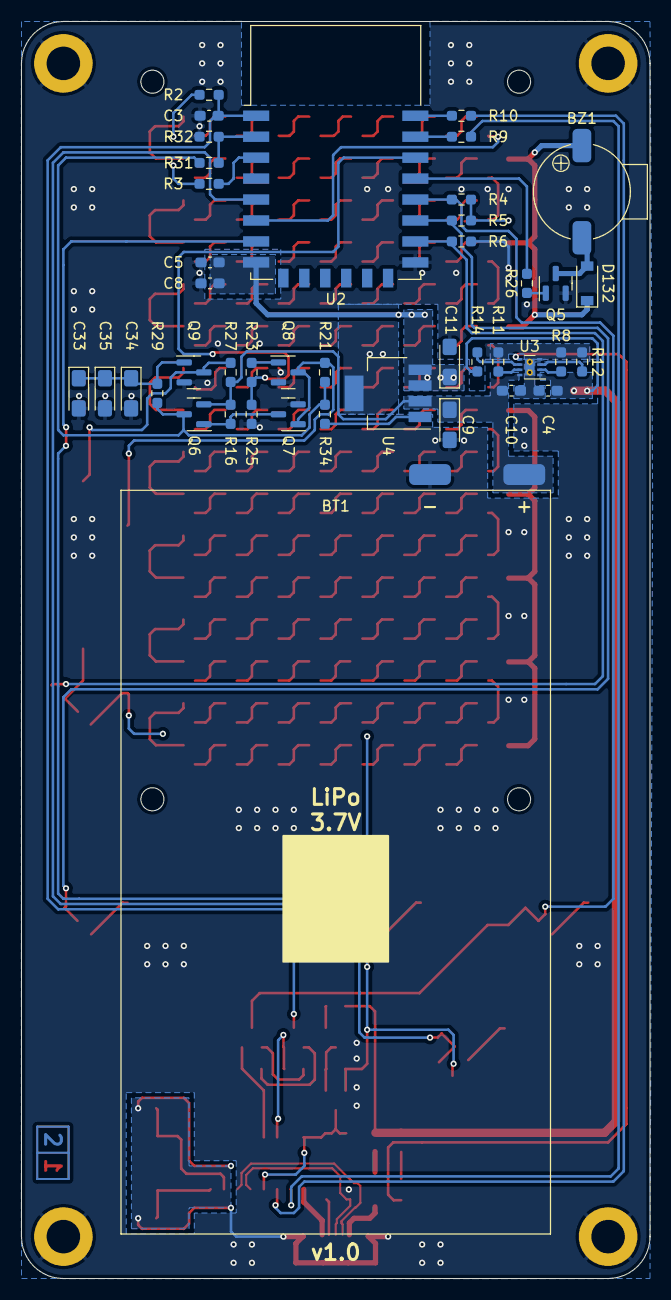
[picture p16: board ESP8266Tetris.kicad_pcb from below]

Board: 2 copper layers, 60.0 x 120.0 mm, 232 parts (42 on the bottom side), 180 nets.
