arraym/ESP8266Tetris/(commit log)

2022-09-11 Initial commit.
    [ESP8266Tetris.kicad_pcb, ESP8266Tetris.kicad_sch]
2022-09-13 Battery charge and 3.3V LDO circuits changed, new datasheets added.
    [ESP8266Tetris.kicad_sch]
2022-09-18 LEDs added to schematic, footprints assigned, PCB layout started.
    [DisplayLED1.kicad_sch, DisplayLED2.kicad_sch, ESP8266Tetris.kicad_pcb, ESP8266Tetris.kicad_sch]
2022-09-20 Soft letching power switch circuit added, buttons reassigned to GPIOs.
    [ESP8266Tetris.kicad_sch]
2022-09-24 Schematic finished, routing PCB started.
    [DisplayLED1.kicad_sch, DisplayLED2.kicad_sch, ESP8266Tetris.kicad_pcb, ESP8266Tetris.kicad_sch]
2022-10-02 Routing PCB done.
    [ESP8266Tetris.kicad_pcb, ESP8266Tetris.kicad_sch]
2022-10-04 Fabrication and assembly files generated (v1.0).
    [ESP8266Tetris-B_Cu.gbr, ESP8266Tetris-B_Mask.gbr, ESP8266Tetris-B_Paste.gbr, ESP8266Tetris-B_Silkscreen.gbr, ESP8266Tetris-Edge_Cuts.gbr, ESP8266Tetris-F_Cu.gbr, ESP8266Tetris-F_Mask.gbr, ESP8266Tetris-F_Paste.gbr]
2022-10-06 Buzzer moved to bottom layer, fabrication and assembly files regenerated.
    [ESP8266Tetris-B_Cu.gbr, ESP8266Tetris-B_Mask.gbr, ESP8266Tetris-B_Paste.gbr, ESP8266Tetris-B_Silkscreen.gbr, ESP8266Tetris-Edge_Cuts.gbr, ESP8266Tetris-F_Cu.gbr, ESP8266Tetris-F_Mask.gbr, ESP8266Tetris-F_Paste.gbr]
2022-11-25 Two lines removed from top silk screen, F_Silkscreen gerber file regenerated.
    [ESP8266Tetris.kicad_pcb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]
2023-01-20 Buttons debounce capacitors value changed from 10n to 220n.
    [ESP8266Tetris.kicad_pcb, ESP8266Tetris.kicad_sch]
2023-02-15 Interactive BOM updated.
2023-02-16 Device pictures added.
